renedeboer/ReneDeBoer_Vleermuis/media/vleermuispakket2.jpg

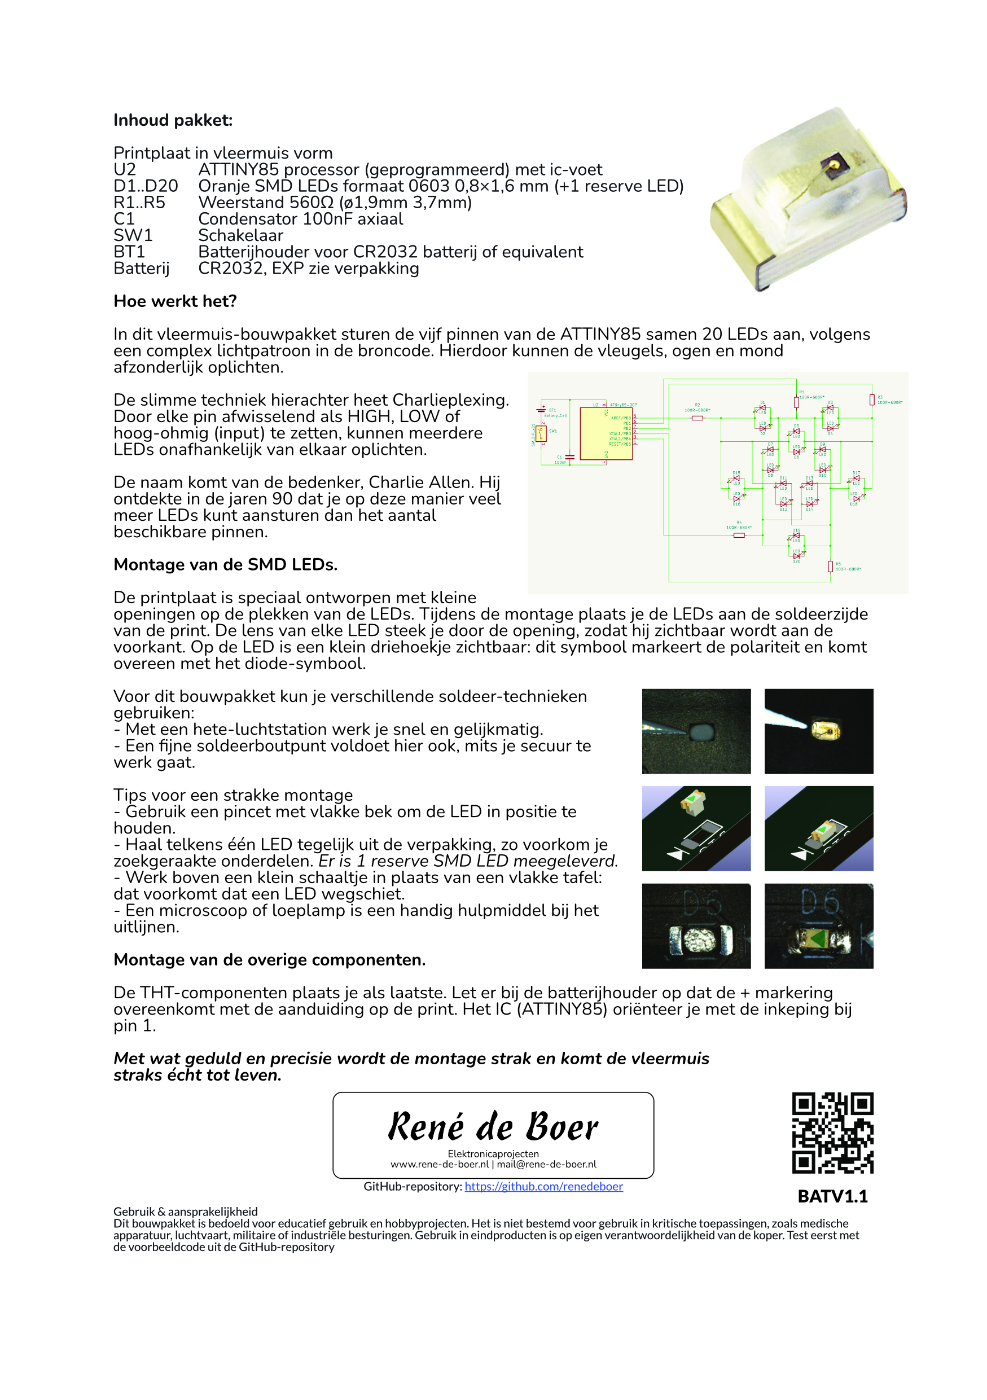
media/vleermuispakket2.jpg
