renedeboer/ReneDeBoer_Vleermuis/media/vleermuispakket.jpg

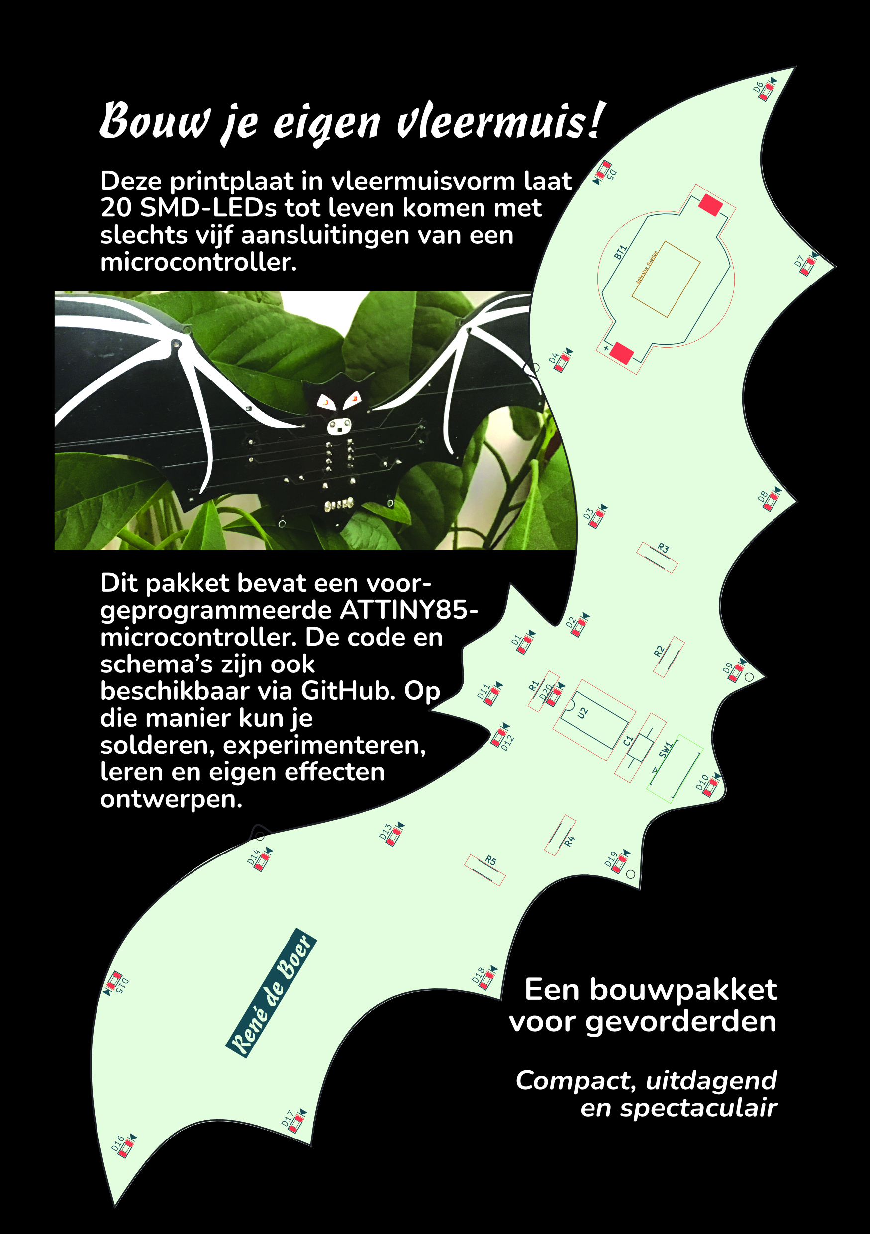
media/vleermuispakket.jpg
