renedeboer/ReneDeBoer_Vleermuis/(commit log)

2025-09-25 Update and rename effecten.ino to LED_patronen_varianten.ino
2025-10-01 Create ATtiny85 programmeren met Arduino UNO als ISP
2025-10-01 Rename ATtiny85 programmeren met Arduino UNO als ISP to ATtiny85 programmeren met Arduino UNO als ISP.md
2025-10-01 Update ATtiny85 programmeren met Arduino UNO als ISP.md
2025-10-01 Rename ATtiny85 programmeren met Arduino UNO als ISP.md to ATtiny85_programmeren_met_Arduino_UNO_als_ISP.md
