renedeboer/ReneDeBoer_Vleermuis/(notices)

Notices in the files:
README.md:
License: Personal Use
